NguyenGiap25072004/Smart-Agriculture-Monitoring-and-Control-System-using-LoRa-network/2_Edge_AI_Server/models/training_loss_chart.png

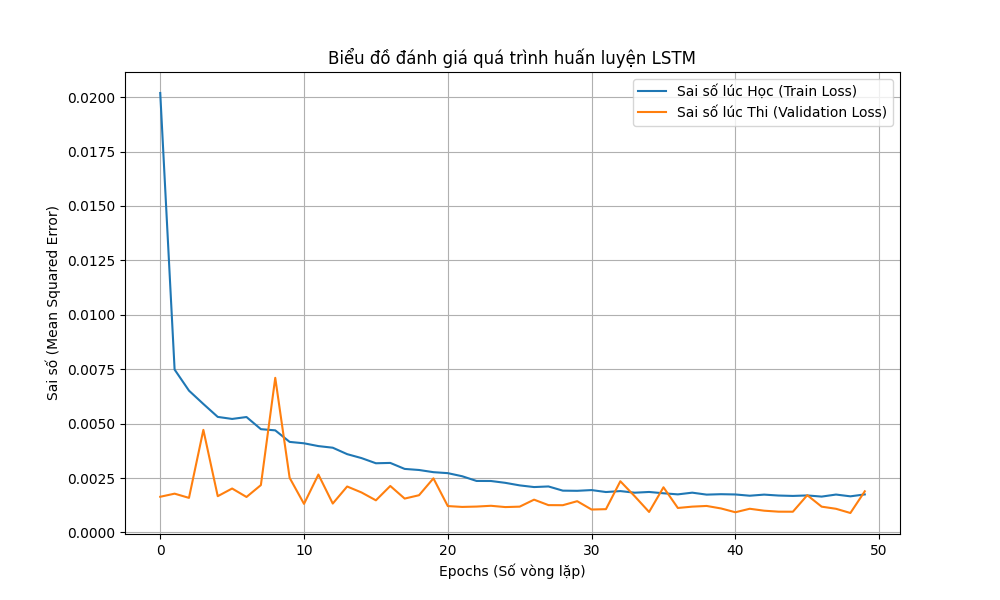
2_Edge_AI_Server/models/training_loss_chart.png
